TobleMiner/T41-USB-C-PSU/T41-USB-C-PSU.kicad_pcb

## KiCad design T41-USB-C-PSU.kicad_pcb (2023-11-26)

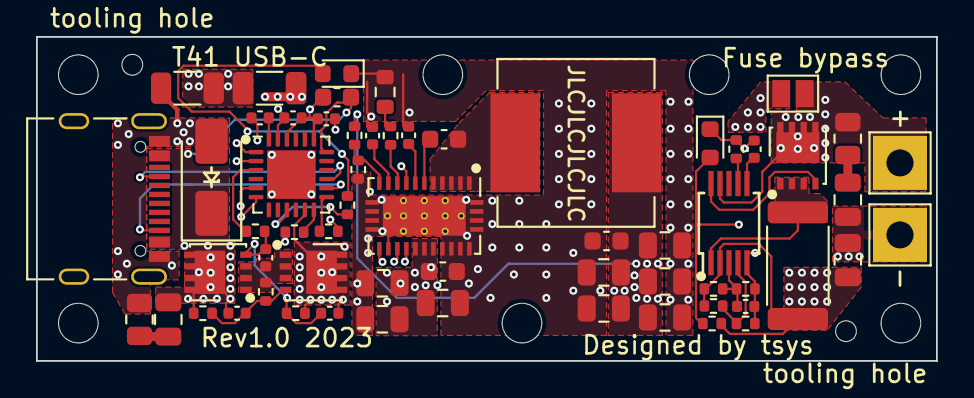
[picture p1: board T41-USB-C-PSU.kicad_pcb from above]

Board: 4 copper layers, 50.0 x 18.0 mm, 71 parts (0 on the bottom side), 33 nets.

Parts:
C1, C7: 470nF; C_0603_1608Metric
C2, C3, C4, C5, C6: 22uF; C_0805_2012Metric
C8: 100nF HV; C_0603_1608Metric
C9, C10, C11, C14, C20, C26: 10uF; C_0805_2012Metric
C12: 22nF; C_0402_1005Metric
C13: 2.2uF; C_0402_1005Metric
C15: 1nF; C_1206_3216Metric
C16: 1uF HV; C_0603_1608Metric
C17, C18, C21, C27: 1uF; C_0402_1005Metric
C19, C22, C23, C24: 100nF; C_0402_1005Metric
D1: SMAJ22A; D_SMA
D2: RED; LED_0603_1608Metric
D3: GRN; LED_0603_1608Metric
H1, H2: ToolingHole; ToolingHole_JLCSMT
H3, H4, H5, H6, H7, H8, H9: MountingHole; MountingHole_2.2mm_M2
J1: USB_C_Receptacle_USB2.0; USB_C_Receptacle_Palconn_UTC16-G
JP1: Fuse disable; SolderJumper-2_P1.3mm_Open_Pad1.0x1.5mm
L1: 3.3uH; L_Sunlord_MWSA0804S
N1: Housing; Generic_Case
Q1, Q2: AP90P03Q; DFN-8-FET_3x3mm_P0.65mm
Q3: NTTFS4C25NTWG; DFN-8-FET_3x3mm_P0.65mm
R1: 2.2k; R_0402_1005Metric
R2, R20: 33k; R_0402_1005Metric
R3: 36k; R_0603_1608Metric
R4: 2.4k; R_0402_1005Metric
R5, R8, R11, R12: 10k; R_0402_1005Metric
R6, R21: 1R; R_0805_2012Metric
R7: 100k HV; R_1206_3216Metric
R9, R10: 100k; R_0402_1005Metric
R13: 50k; R_0402_1005Metric
R14: 12k; R_0402_1005Metric
R15, R17: 120k; R_0402_1005Metric
R16: 20k; R_0402_1005Metric
R18: 10m; R_2512_6332Metric
R19: 1k; R_0402_1005Metric
TP1: OUT+; TestPoint_THTPad_3.0x3.0mm_Drill1.5mm
TP2: OUT-; TestPoint_THTPad_3.0x3.0mm_Drill1.5mm
U1: LM73606; WQFN-30-4x6mm-EP2.2x4.6mm_P0.5mm
U2: CYPD3177; QFN-24-1EP_4x4mm_P0.5mm_EP2.7x2.7mm
U3: LM5069; MSOP-10_3x3mm_P0.5mm

Connections:
+3V3: C18.1, C19.1, R11.1, R12.1, U2.1 (VBUS_MIN), U2.2 (VBUS_MAX), U2.5 (ISNK_COARSE), U2.23 (VDDD)
/Buck converter/PGOOD: D3.2 (A), R20.2, U1.16 (PGOOD)
/Buck converter/VOUT: C2.1, C3.1, C4.1, C5.1, C6.1, C7.1, C20.1, JP1.1 (A), L1.2, R2.1, R13.1, R15.1, R18.1, R20.1, U1.8 (BIAS), U3.2 (VIN)
/Output protection/OUT: JP1.2 (B), Q3.5 (D), R21.1, TP1.1, U3.9 (OUT)
/USB input/FAULT: R19.1, U2.9 (FAULT)
GND: C2.2, C3.2, C4.2, C5.2, C6.2, C7.2, C8.2, C9.2, C10.2, C11.2, C12.2, C13.2, C15.2, C16.2, C17.2, C18.2, C19.2, C20.2, C24.2, C26.2, C27.2, D1.2 (A2), D2.1 (K), D3.1 (K), J1.A1 (GND), J1.A12 (GND), J1.B1 (GND), J1.B12 (GND), R1.2, R3.1, R6.2, R7.2, R14.2, R16.2, R17.2, TP2.1, U1.12 (PGND), U1.13 (PGND), U1.14 (PGND), U1.15 (PGND), U1.17 (SYNC/MODE), U1.19 (AGND), U1.23 (PGND), U1.24 (PGND), U1.25 (PGND), U1.26 (PGND), U1.27 (PGND), U1.28 (PGND), U1.29 (PGND), U1.30 (PGND), U1.31 (PGND), U2.6 (ISNK_FINE), U2.19 (GND), U2.22 (VSS), U2.25 (GND), U3.5 (GND)
unnamed: C1.1, L1.1, U1.1 (SW), U1.2 (SW), U1.3 (SW), U1.4 (SW), U1.5 (SW)
unnamed: C14.2, R6.1
unnamed: C21.1, Q1.1 (S), Q1.2 (S), Q1.3 (S), Q2.1 (S), Q2.2 (S), Q2.3 (S), R8.1
unnamed: C26.1, R21.2
unnamed: C14.1, C16.1, C22.1, D1.1 (A1), J1.A4 (VBUS), J1.A9 (VBUS), J1.B4 (VBUS), J1.B9 (VBUS), Q1.5 (D), R9.1, U2.18 (VBUS_IN)
unnamed: D2.2 (A), R19.2
unnamed: J1.A5 (CC1), U2.15 (CC1)
unnamed: J1.B5 (CC2), U2.14 (CC2)
unnamed: C15.1, J1.S1 (SHIELD), R7.1
unnamed: C21.2, C22.2, C23.2, Q1.4 (G), Q2.4 (G), R5.1, R8.2, R9.2, R10.2
unnamed: Q3.4 (G), U3.10 (GATE)
unnamed: R3.2, R4.2
unnamed: C1.2, U1.6 (CBOOT)
unnamed: R1.1, R2.2, U1.11 (FB)
unnamed: R4.1, U1.9 (RT)
unnamed: C12.1, U1.10 (SS/TRK)
unnamed: C13.1, U1.7 (VCC)
unnamed: R12.2, U2.13 (HPI_SCL)
unnamed: R11.2, U2.12 (HPI_SDA)
unnamed: R5.2, U2.3 (VBUS_FET_EN)
unnamed: C17.1, U2.24 (VCCD)
unnamed: R15.2, R16.1, U3.4 (OVLO)
unnamed: R17.1, U3.7 (PWR)
unnamed: Q3.1 (S), Q3.2 (S), Q3.3 (S), R18.2, U3.1 (SENSE)
unnamed: C27.1, U3.6 (TIMER)
unnamed: C24.1, R13.2, R14.1, U3.3 (UVLO)
PVIN: C8.1, C9.1, C10.1, C11.1, C23.1, Q2.5 (D), R10.1, U1.18 (EN), U1.20 (PVIN), U1.21 (PVIN), U1.22 (PVIN), U2.11 (VDC_OUT)
