TobleMiner/T41-USB-C-PSU/(commit log)

2023-09-13 Hide silkscreen designators
    [T41-USB-C-PSU.kicad_pcb]
2023-09-14 Add tooling holes
    [T41-USB-C-PSU.kicad_pcb, T41-USB-C-PSU.kicad_sch]
2023-09-15 Add status LEDs
    [T41-USB-C-PSU.kicad_pcb, T41-USB-C-PSU.kicad_sch]
2023-09-15 Improve VOUT plane connectivity
    [T41-USB-C-PSU.kicad_pcb]
2023-09-15 Route ISNK to be more easily reachable in case bodging is required
    [T41-USB-C-PSU.kicad_pcb]
2023-09-15 Fix 33k resistor partnumber
    [buck.kicad_sch]
2023-09-15 Use Droid Sans for silkscreen text
    [T41-USB-C-PSU.kicad_pcb]
2023-11-21 Add case design
    [case.scad]
2023-11-21 case: add additional interlocking features
    [case.scad]
2023-11-21 case: add some wiggle room for USB-C port
    [case.scad]
2023-11-26 Add generic case footprint
    [T41-USB-C-PSU.kicad_pcb, T41-USB-C-PSU.kicad_sch]
2023-11-26 Add cutouts in SLM DFM
    [case.scad]
2024-03-10 case: increase manufacturing tolerances for JLC3DP SLM process
    [case.scad]
